KQGP/KQC/KQC.kicad_pcb

## KiCad design KQC.kicad_pcb (2025-04-21)

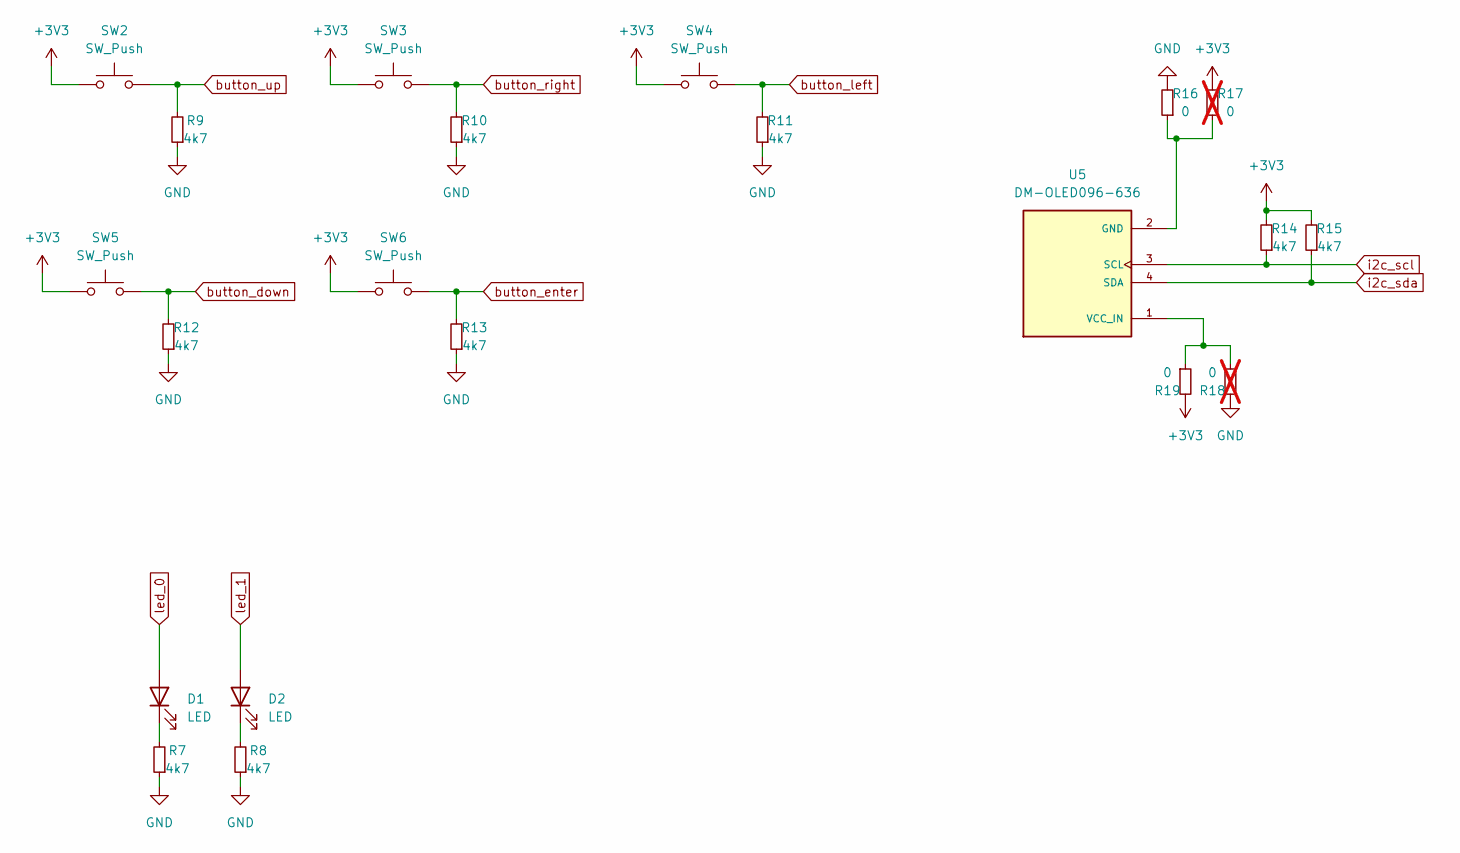
[picture p1: schematic dio_oled.kicad_sch]

Parts:
D1, D2: LED; LED_0603_1608Metric
R7, R8, R9, R10, R11, R12, R13, R14, R15: 4k7; R_0603_1608Metric
R16, R19: 0; R_0603_1608Metric
R17, R18: 0; R_0603_1608Metric; not fitted
SW2, SW3, SW4, SW5, SW6: SW_Push; SW_Push_1P1T_NO_6x6mm_H9.5mm; JLCPCB Part # C455109
U5: DM-OLED096-636; oled_1.3; PARTREV 2018-09-10

Connections:
+3V3: R14.2, R15.2, R17.2, R19.2, SW2.1, SW3.1, SW4.1, SW5.1, SW6.1; also elsewhere on the board
GND: R7.1, R8.1, R9.1, R10.1, R11.1, R12.1, R13.1, R16.2, R18.2; also elsewhere on the board
unnamed: D1.1 (K), R7.2
unnamed: D2.1 (K), R8.2
unnamed: R16.1, R17.1, U5.2 (GND)
unnamed: R18.1, R19.1, U5.1 (VCC_IN)
button_down: R12.2, SW5.2; also elsewhere on the board
button_enter: R13.2, SW6.2; also elsewhere on the board
button_left: R11.2, SW4.2; also elsewhere on the board
button_right: R10.2, SW3.2; also elsewhere on the board
button_up: R9.2, SW2.2; also elsewhere on the board
i2c_scl: R14.1, U5.3 (SCL); also elsewhere on the board
i2c_sda: R15.1, U5.4 (SDA); also elsewhere on the board
led_0: D1.2 (A); also elsewhere on the board
led_1: D2.2 (A); also elsewhere on the board

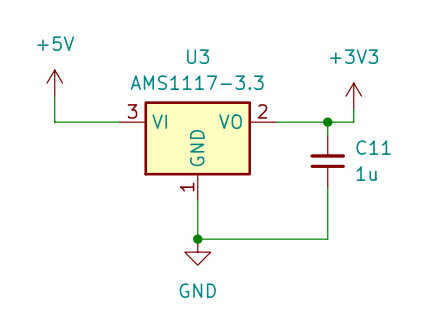
[picture p2: schematic supply.kicad_sch]

Parts:
C11: 1u; C_0603_1608Metric
U3: AMS1117-3.3; SOT-223-3_TabPin2

Connections:
+3V3: C11.2, U3.2 (VO); also elsewhere on the board
+5V: U3.3 (VI); also elsewhere on the board
GND: C11.1, U3.1 (GND); also elsewhere on the board

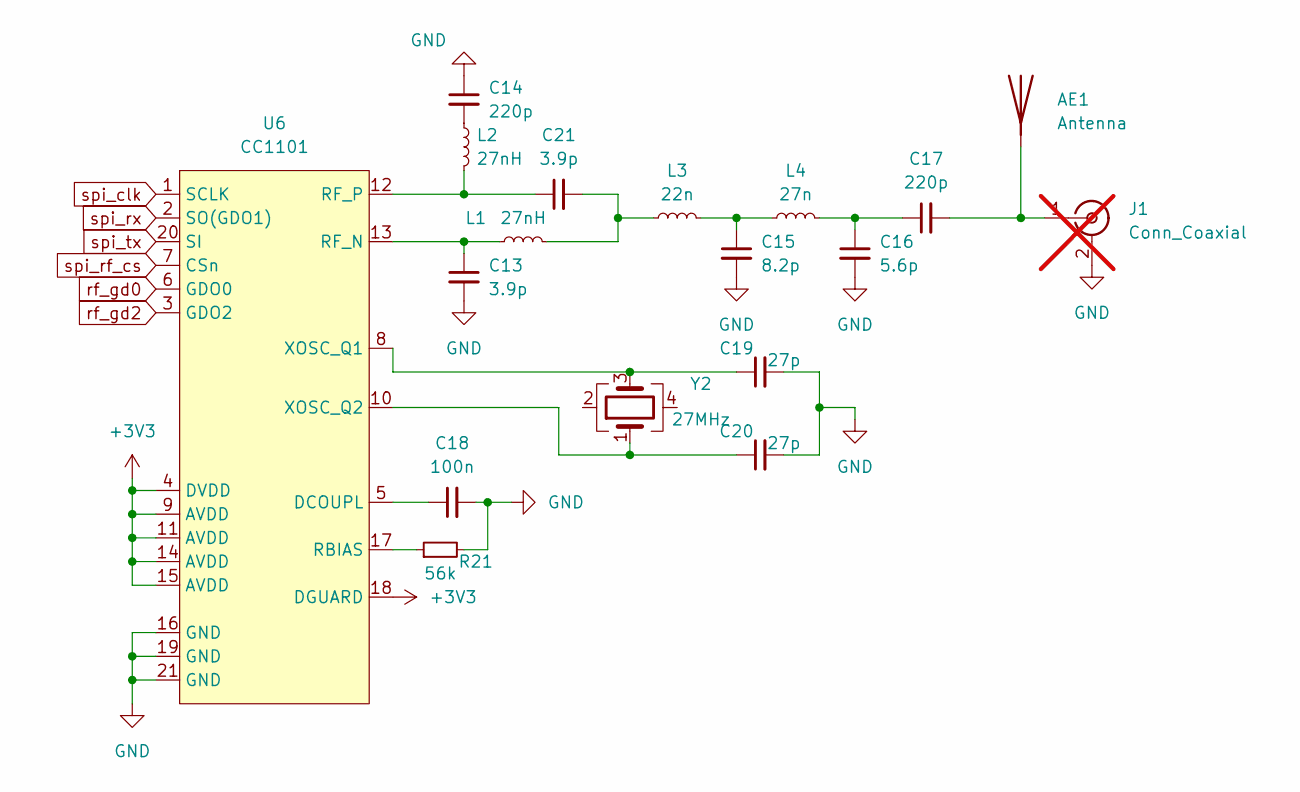
[picture p3: schematic rf.kicad_sch]

Parts:
AE1: Antenna; TestPoint_THTPad_1.5x1.5mm_Drill0.7mm
C13, C21: 3.9p; C_0402_1005Metric
C14, C17: 220p; C_0402_1005Metric
C15: 8.2p; C_0402_1005Metric
C16: 5.6p; C_0402_1005Metric
C18: 100n; C_0402_1005Metric
C19, C20: 27p; C_0402_1005Metric
J1: Conn_Coaxial; SMA_Amphenol_132289_EdgeMount; not fitted
L1, L2: 27nH; L_0402_1005Metric
L3: 22n; L_0402_1005Metric
L4: 27n; L_0402_1005Metric
R21: 56k; R_0402_1005Metric
U6: CC1101; QFN-20-1EP_4x4mm_P0.5mm_EP2.6x2.6mm_ThermalVias; JLCPCB Part # C29953
Y2: 27MHz; Crystal_SMD_3225-4Pin_3.2x2.5mm; JLCPCB Part # C254353

Connections:
+3V3: U6.4 (DVDD), U6.9 (AVDD), U6.11 (AVDD), U6.14 (AVDD), U6.15 (AVDD), U6.18 (DGUARD); also elsewhere on the board
GND: C13.2, C14.1, C15.2, C16.2, C18.2, C19.2, C20.2, J1.2 (Ext), R21.2, U6.16 (GND), U6.19 (GND), U6.21 (GND); also elsewhere on the board
unnamed: AE1.1 (A), C17.2, J1.1 (In)
unnamed: C14.2, L2.1
unnamed: C15.1, L3.2, L4.1
unnamed: C16.1, C17.1, L4.2
unnamed: C21.2, L1.2, L3.1
unnamed: C18.1, U6.5 (DCOUPL)
unnamed: R21.1, U6.17 (RBIAS)
unnamed: C13.1, L1.1, U6.13 (RF_N)
unnamed: C21.1, L2.2, U6.12 (RF_P)
unnamed: C19.1, U6.8 (XOSC_Q1), Y2.3
unnamed: C20.1, U6.10 (XOSC_Q2), Y2.1
rf_gd0: U6.6 (GDO0); also elsewhere on the board
rf_gd2: U6.3 (GDO2); also elsewhere on the board
spi_clk: U6.1 (SCLK); also elsewhere on the board
spi_rf_cs: U6.7 (CSn); also elsewhere on the board
spi_rx: U6.2 (SO(GDO1)); also elsewhere on the board
spi_tx: U6.20 (SI); also elsewhere on the board

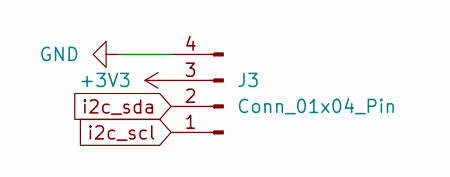
[picture p4: schematic nfc.kicad_sch]

Parts:
J3: Conn_01x04_Pin; PinHeader_1x04_P2.54mm_Vertical

Connections:
+3V3: J3.3; also elsewhere on the board
GND: J3.4; also elsewhere on the board
i2c_scl: J3.1; also elsewhere on the board
i2c_sda: J3.2; also elsewhere on the board

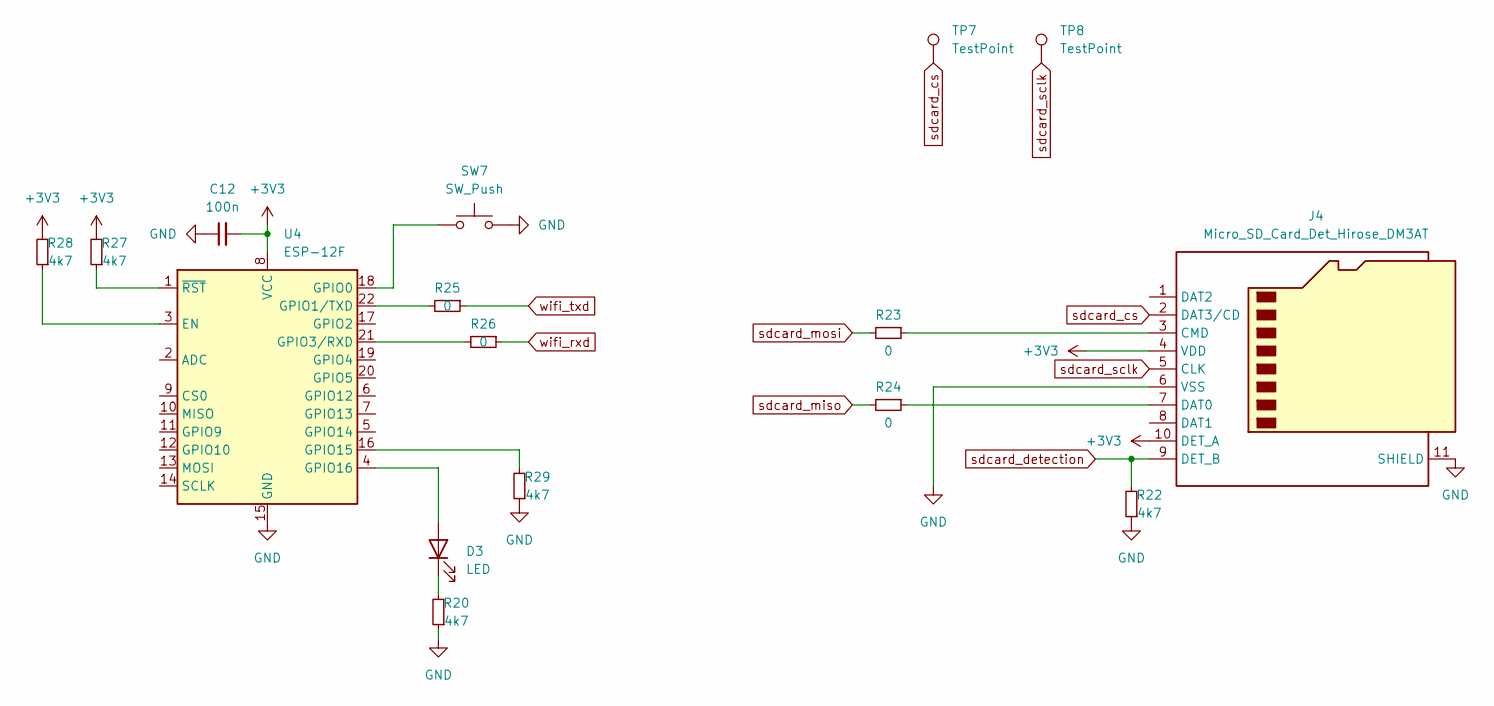
[picture p5: schematic wifi.kicad_sch]

Parts:
C12: 100n; C_0603_1608Metric
D3: LED; LED_0603_1608Metric
J4: Micro_SD_Card_Det_Hirose_DM3AT; microSD_HC_Hirose_DM3AT-SF-PEJM5; JLCPCB Part # C114218
R20, R22, R27, R28, R29: 4k7; R_0603_1608Metric
R23, R24, R25, R26: 0; R_0603_1608Metric
SW7: SW_Push; SW_Push_SPST_NO_Alps_SKRK; JLCPCB Part # C115357
TP7, TP8: TestPoint; TestPoint_Pad_D1.0mm
U4: ESP-12F; ESP-12E; JLCPCB Part # C784365

Connections:
+3V3: C12.2, J4.4 (VDD), J4.10 (DET_A), R27.2, R28.2, U4.8 (VCC); also elsewhere on the board
GND: C12.1, J4.6 (VSS), J4.11 (SHIELD), R20.1, R22.1, R29.1, SW7.2, U4.15 (GND); also elsewhere on the board
unnamed: D3.2 (A), U4.4 (GPIO16)
unnamed: D3.1 (K), R20.2
unnamed: J4.3 (CMD), R23.1
unnamed: J4.7 (DAT0), R24.1
unnamed: R28.1, U4.3 (EN)
unnamed: SW7.1, U4.18 (GPIO0)
unnamed: R25.2, U4.22 (GPIO1/TXD)
unnamed: R26.2, U4.21 (GPIO3/RXD)
unnamed: R29.2, U4.16 (GPIO15)
unnamed: R27.1, U4.1 (~RST)
sdcard_cs: J4.2 (DAT3/CD), TP7.1; also elsewhere on the board
sdcard_detection: J4.9 (DET_B), R22.2; also elsewhere on the board
sdcard_miso: R24.2; also elsewhere on the board
sdcard_mosi: R23.2; also elsewhere on the board
sdcard_sclk: J4.5 (CLK), TP8.1; also elsewhere on the board
wifi_rxd: R26.1; also elsewhere on the board
wifi_txd: R25.1; also elsewhere on the board

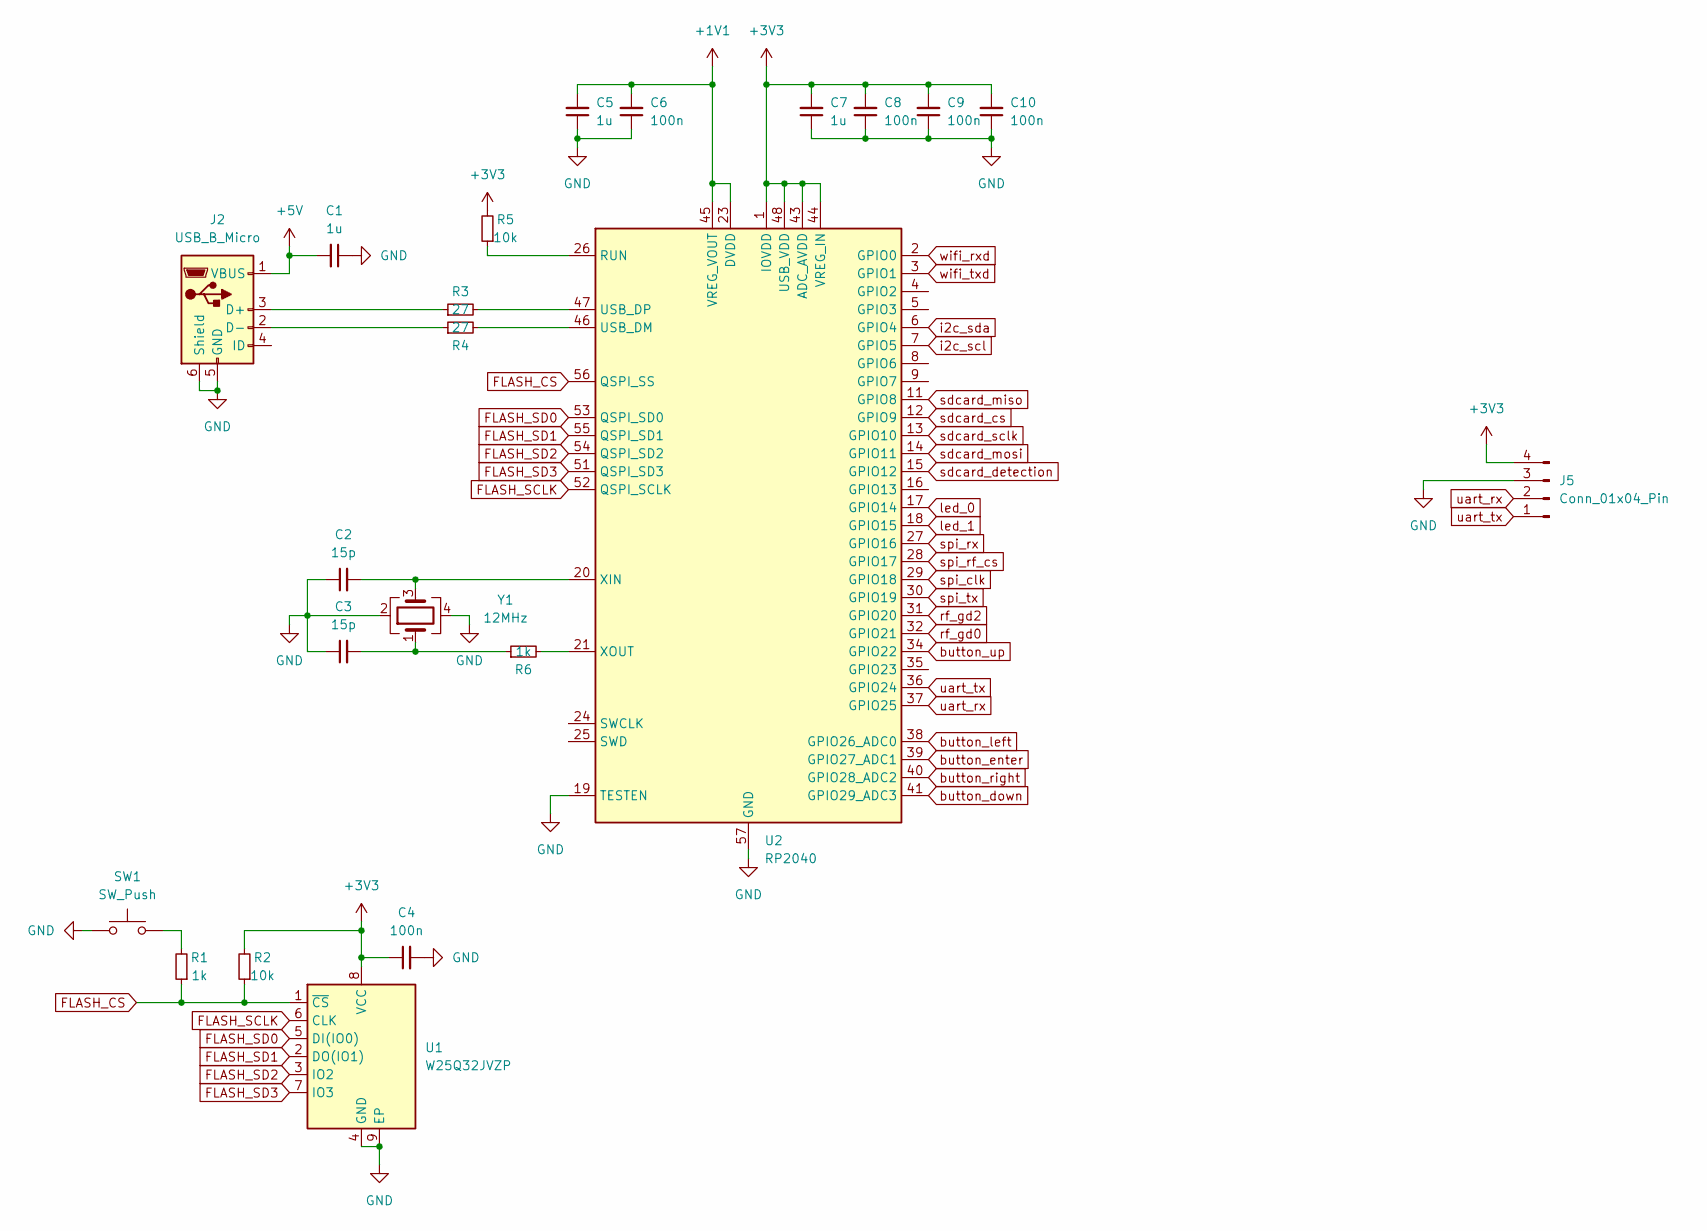
[picture p6: schematic rp2040.kicad_sch]

Parts:
C1, C5, C7: 1u; C_0603_1608Metric
C2, C3: 15p; C_0603_1608Metric
C4, C6, C8, C9, C10: 100n; C_0603_1608Metric
J2: USB_B_Micro; USB_Micro-B_Amphenol_10118193-0001LF_Horizontal; JLCPCB Part # C132562
J5: Conn_01x04_Pin; PinHeader_1x04_P2.54mm_Horizontal
R1, R6: 1k; R_0603_1608Metric
R2, R5: 10k; R_0603_1608Metric
R3, R4: 27; R_0603_1608Metric
SW1: SW_Push; SW_Push_SPST_NO_Alps_SKRK; JLCPCB Part # C115357
U1: W25Q32JVZP; WSON-8-1EP_6x5mm_P1.27mm_EP3.4x4.3mm; JLCPCB Part # C2940197
U2: RP2040; QFN-56-1EP_7x7mm_P0.4mm_EP3.2x3.2mm; JLCPCB Part # C2040
Y1: 12MHz; Crystal_SMD_3225-4Pin_3.2x2.5mm; JLCPCB Part # C524716

Connections:
+1V1: C5.2, C6.2, U2.23 (DVDD), U2.45 (VREG_VOUT), U2.50 (DVDD)
+3V3: C4.1, C7.2, C8.2, C9.2, C10.2, J5.4, R2.2, R5.2, U1.8 (VCC), U2.1 (IOVDD), U2.10 (IOVDD), U2.22 (IOVDD), U2.33 (IOVDD), U2.42 (IOVDD), U2.43 (ADC_AVDD), U2.44 (VREG_IN), U2.48 (USB_VDD), U2.49 (IOVDD); also elsewhere on the board
+5V: C1.2, J2.1 (VBUS); also elsewhere on the board
FLASH_CS: R1.1, R2.1, U1.1 (~CS), U2.56 (QSPI_SS)
FLASH_SCLK: U1.6 (CLK), U2.52 (QSPI_SCLK)
FLASH_SD0: U1.5 (DI(IO0)), U2.53 (QSPI_SD0)
FLASH_SD1: U1.2 (DO(IO1)), U2.55 (QSPI_SD1)
FLASH_SD2: U1.3 (IO2), U2.54 (QSPI_SD2)
FLASH_SD3: U1.7 (IO3), U2.51 (QSPI_SD3)
GND: C1.1, C2.1, C3.1, C4.2, C5.1, C6.1, C7.1, C8.1, C9.1, C10.1, J2.5 (GND), J2.6 (Shield), J5.3, SW1.1, U1.4 (GND), U1.9 (EP), U2.19 (TESTEN), U2.57 (GND), Y1.2, Y1.4; also elsewhere on the board
unnamed: C3.2, R6.1, Y1.1
unnamed: J2.3 (D+), R3.1
unnamed: J2.2 (D-), R4.1
unnamed: R1.2, SW1.2
unnamed: R5.1, U2.26 (RUN)
unnamed: R4.2, U2.46 (USB_DM)
unnamed: R3.2, U2.47 (USB_DP)
unnamed: C2.2, U2.20 (XIN), Y1.3
unnamed: R6.2, U2.21 (XOUT)
button_down: U2.41 (GPIO29_ADC3); also elsewhere on the board
button_enter: U2.39 (GPIO27_ADC1); also elsewhere on the board
button_left: U2.38 (GPIO26_ADC0); also elsewhere on the board
button_right: U2.40 (GPIO28_ADC2); also elsewhere on the board
button_up: U2.34 (GPIO22); also elsewhere on the board
i2c_scl: U2.7 (GPIO5); also elsewhere on the board
i2c_sda: U2.6 (GPIO4); also elsewhere on the board
led_0: U2.17 (GPIO14); also elsewhere on the board
led_1: U2.18 (GPIO15); also elsewhere on the board
rf_gd0: U2.32 (GPIO21); also elsewhere on the board
rf_gd2: U2.31 (GPIO20); also elsewhere on the board
sdcard_cs: U2.12 (GPIO9); also elsewhere on the board
sdcard_detection: U2.15 (GPIO12); also elsewhere on the board
sdcard_miso: U2.11 (GPIO8); also elsewhere on the board
sdcard_mosi: U2.14 (GPIO11); also elsewhere on the board
sdcard_sclk: U2.13 (GPIO10); also elsewhere on the board
spi_clk: U2.29 (GPIO18); also elsewhere on the board
spi_rf_cs: U2.28 (GPIO17); also elsewhere on the board
spi_rx: U2.27 (GPIO16); also elsewhere on the board
spi_tx: U2.30 (GPIO19); also elsewhere on the board
uart_rx: J5.2, U2.37 (GPIO25)
uart_tx: J5.1, U2.36 (GPIO24)
wifi_rxd: U2.2 (GPIO0); also elsewhere on the board
wifi_txd: U2.3 (GPIO1); also elsewhere on the board

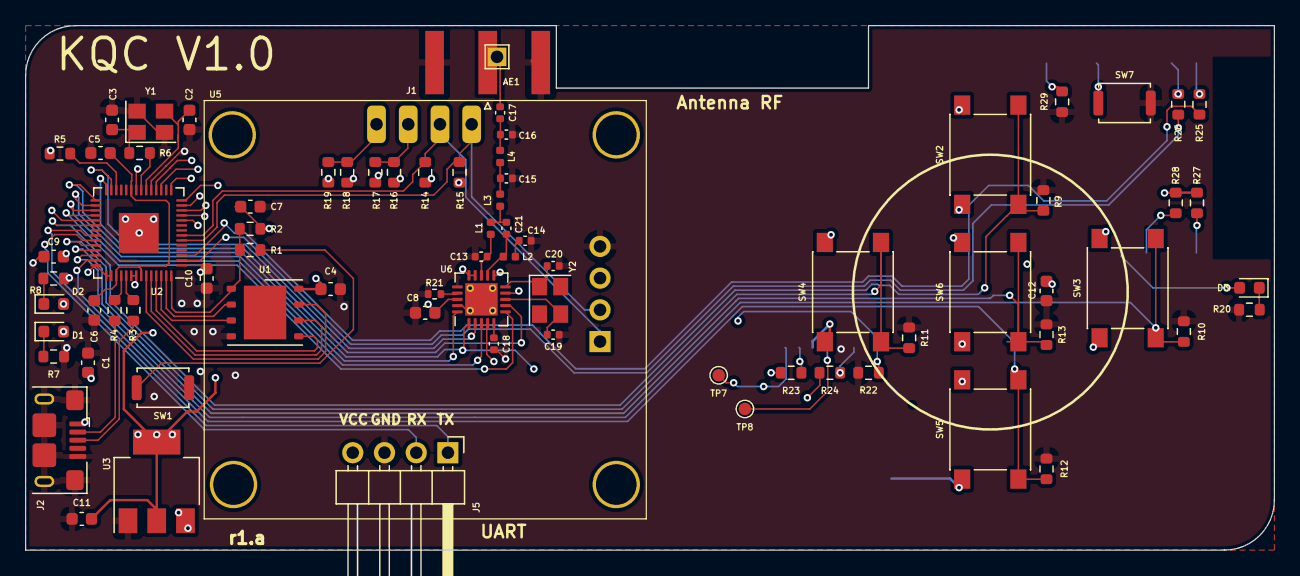
[picture p7: board KQC.kicad_pcb from above]

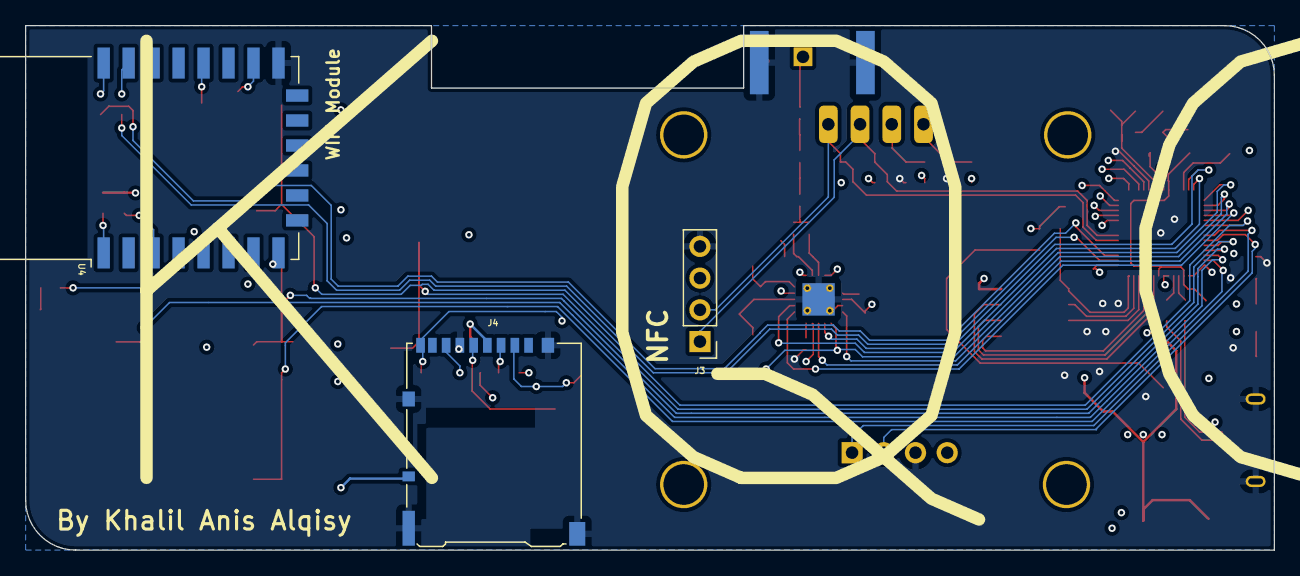
[picture p8: board KQC.kicad_pcb from below]

Board: 4 copper layers, 100.0 x 42.0 mm, 80 parts (3 on the bottom side), 68 nets.
